kghite/accessible_spinner/cad_files/spinner_support.STL

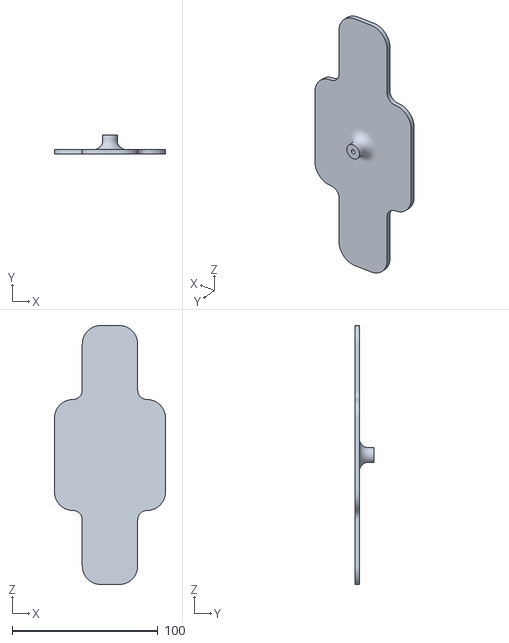
[picture p1: CAD file, 2018-05-11]
cad_files/spinner_support.STL
76.2 x 13.0 x 177.8
