kghite/accessible_spinner/cad_files/motor_mount.STL

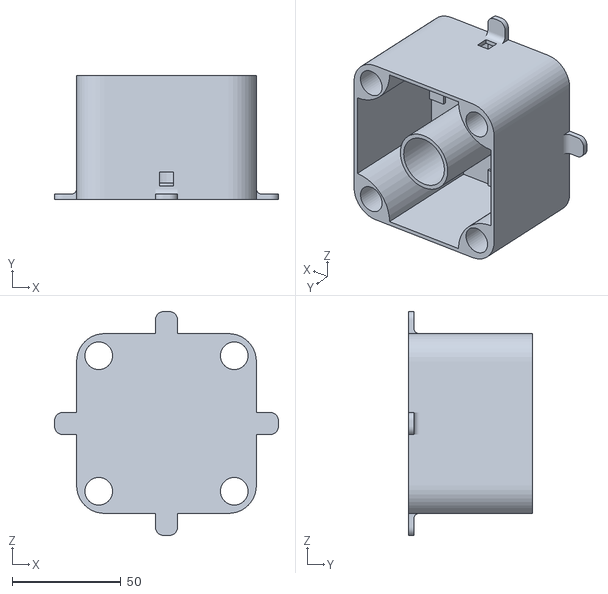
[picture p2: CAD file, 2018-05-11]
cad_files/motor_mount.STL
102.9 x 57.1 x 102.9
