kghite/accessible_spinner/(commit log)

2018-05-09 materials table
2018-05-11 Upload STL files
    [motor_mount.STL, spinner_support.STL]
2018-05-11 Move CAD
    [motor_mount.STL, spinner_support.STL]
